tschutter/digital-dc-power-supply/doc/buttons.gif

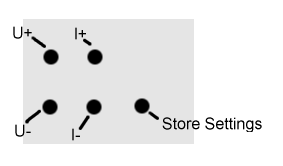
doc/buttons.gif
