tschutter/digital-dc-power-supply/software/circuit/powersupply_upd2.gif

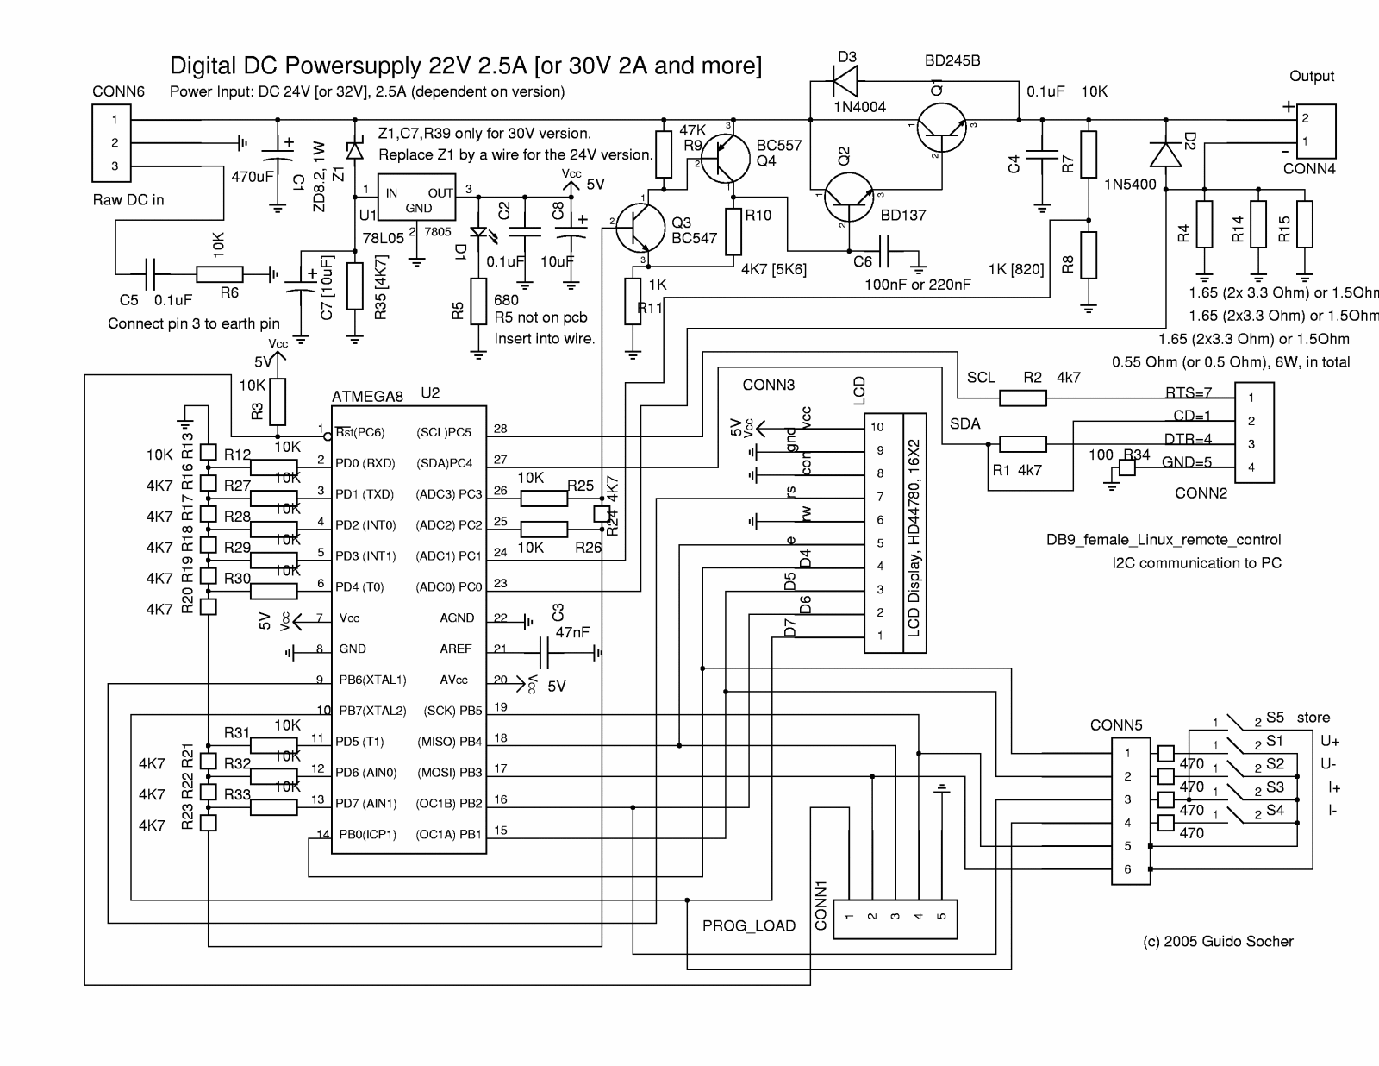
software/circuit/powersupply_upd2.gif
