tschutter/digital-dc-power-supply/software/circuit/powersupply_upd2.png

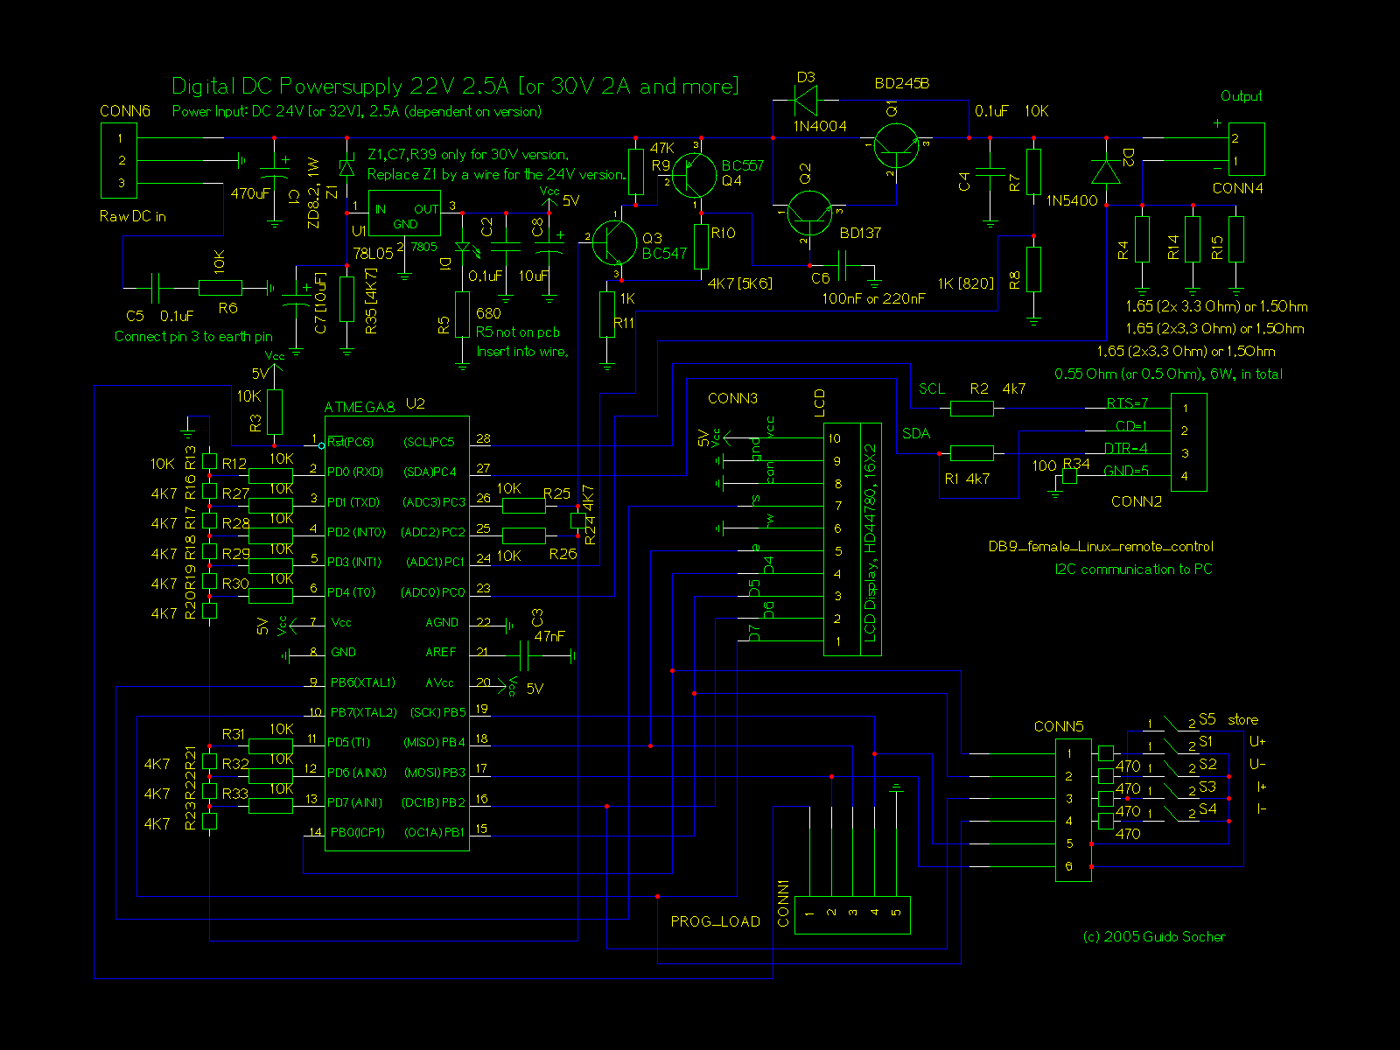
software/circuit/powersupply_upd2.png
