tschutter/digital-dc-power-supply/software/circuit/powersupply_upd3.png

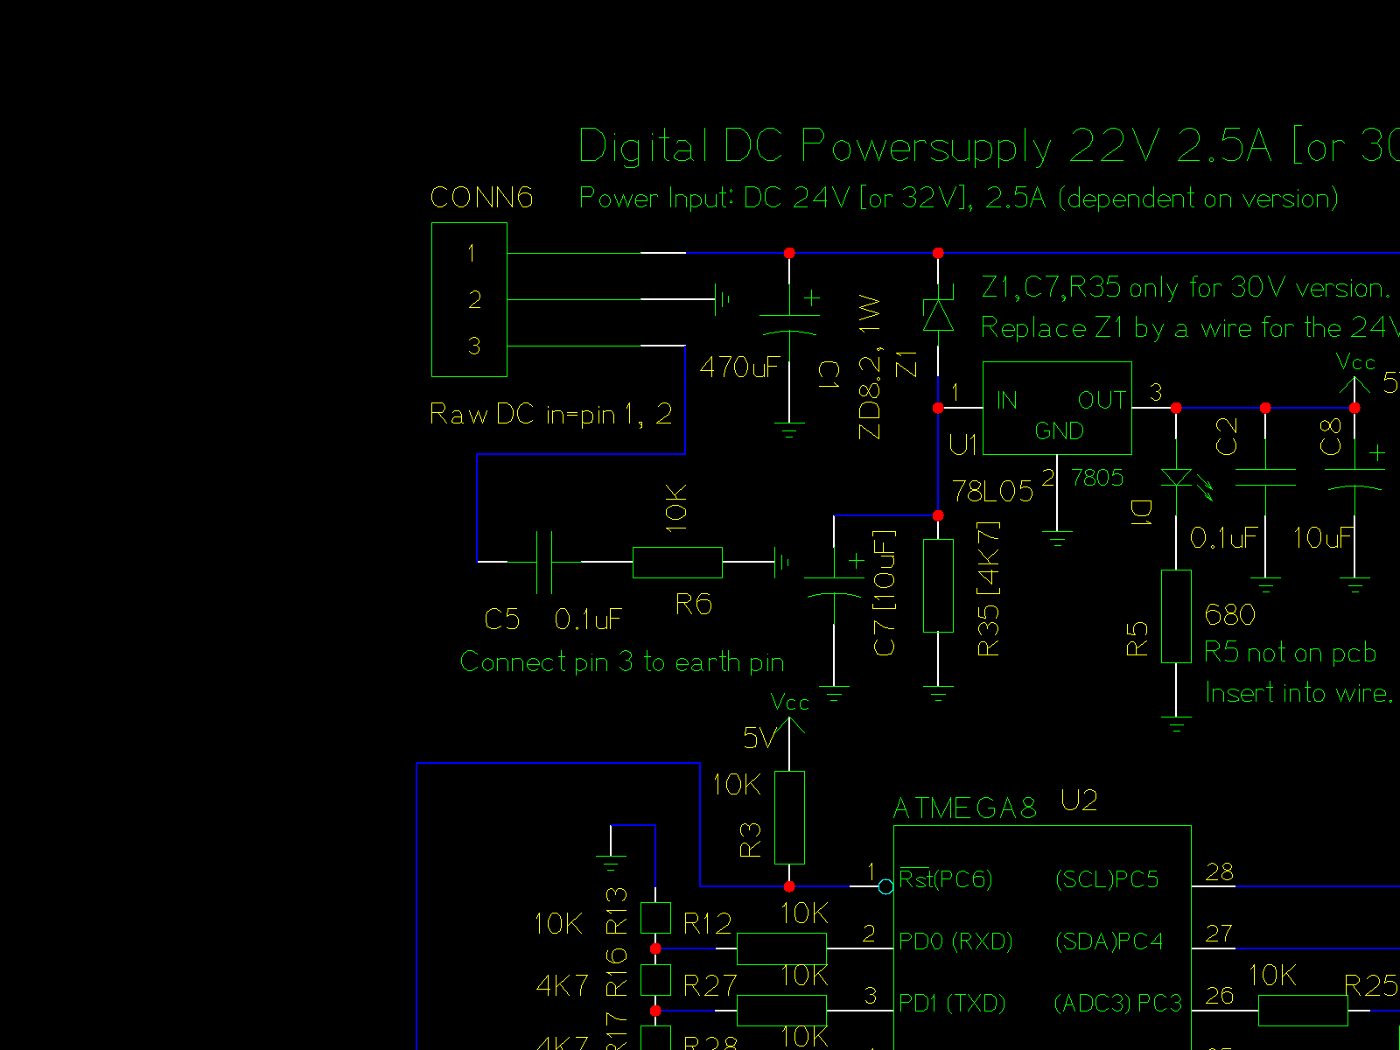
software/circuit/powersupply_upd3.png
