tschutter/digital-dc-power-supply/software/circuit/powersupply_upd4.gif

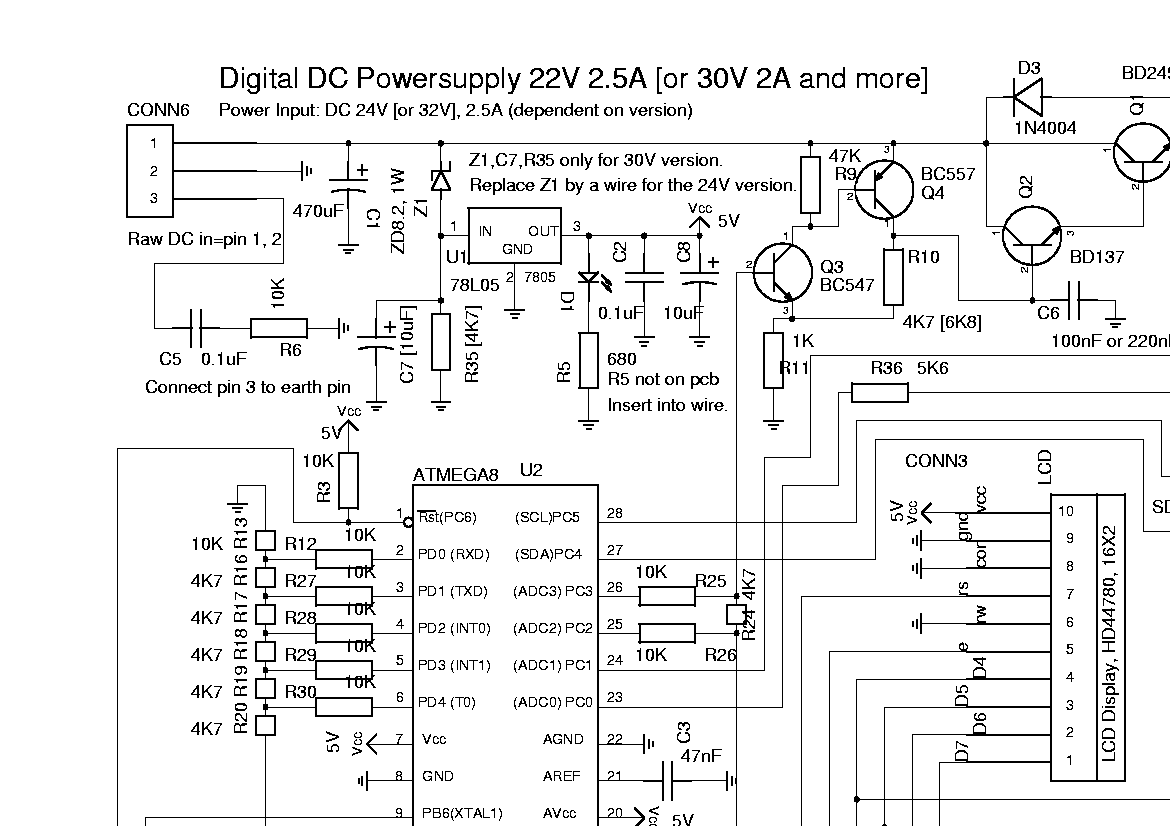
software/circuit/powersupply_upd4.gif
