tschutter/digital-dc-power-supply/software/circuit/powersupply_upd4.png

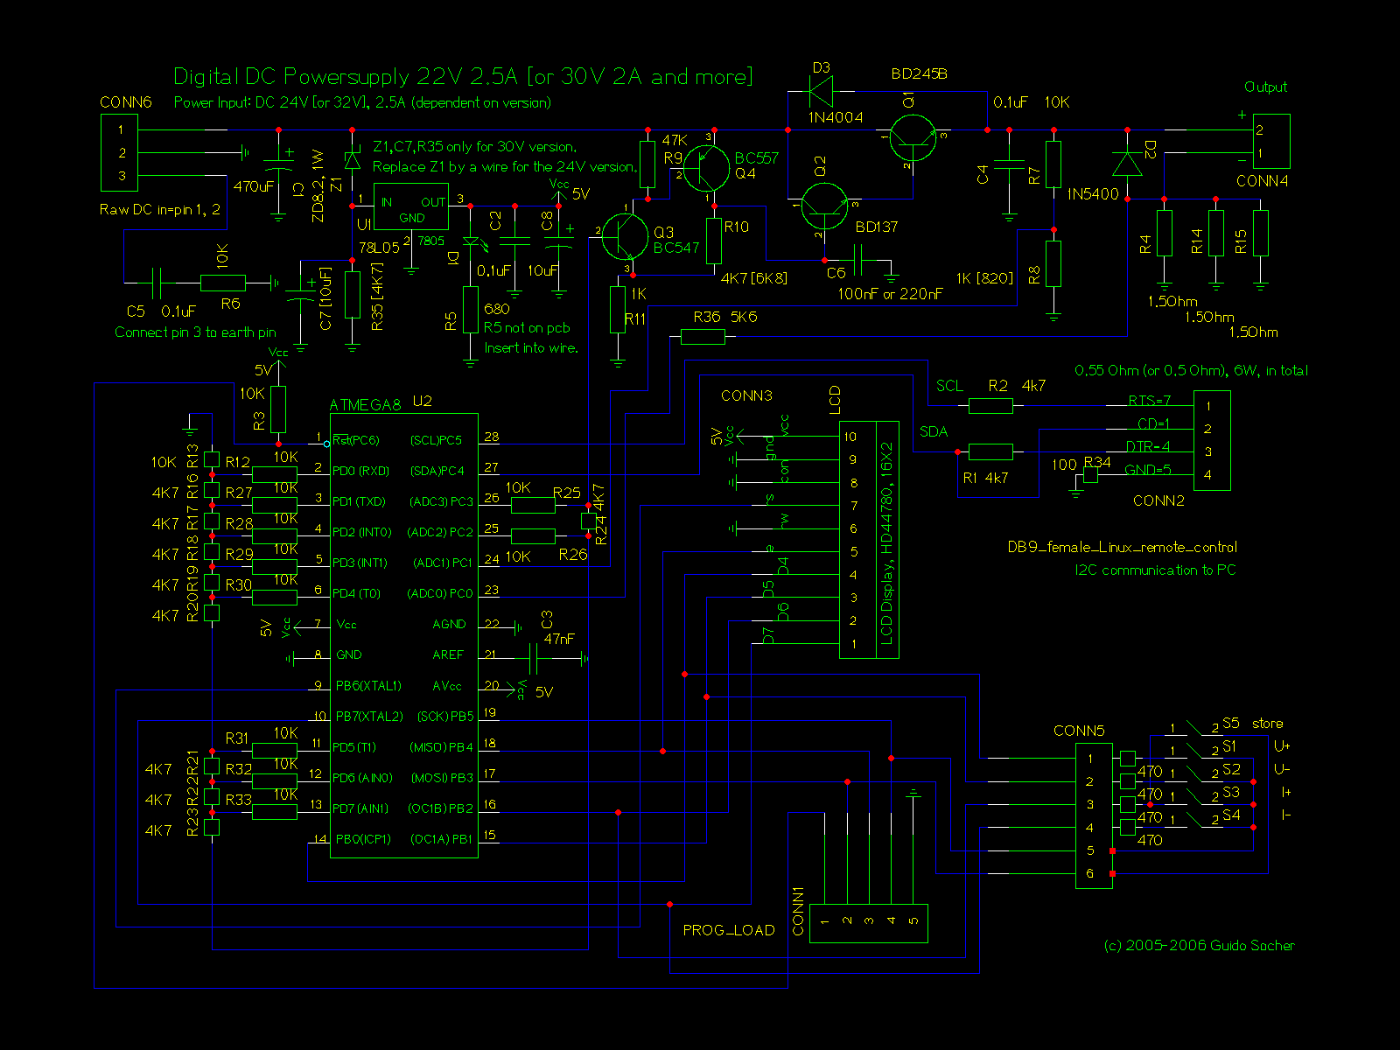
software/circuit/powersupply_upd4.png
