tschutter/digital-dc-power-supply/software/circuit/powersupply_upd.gif

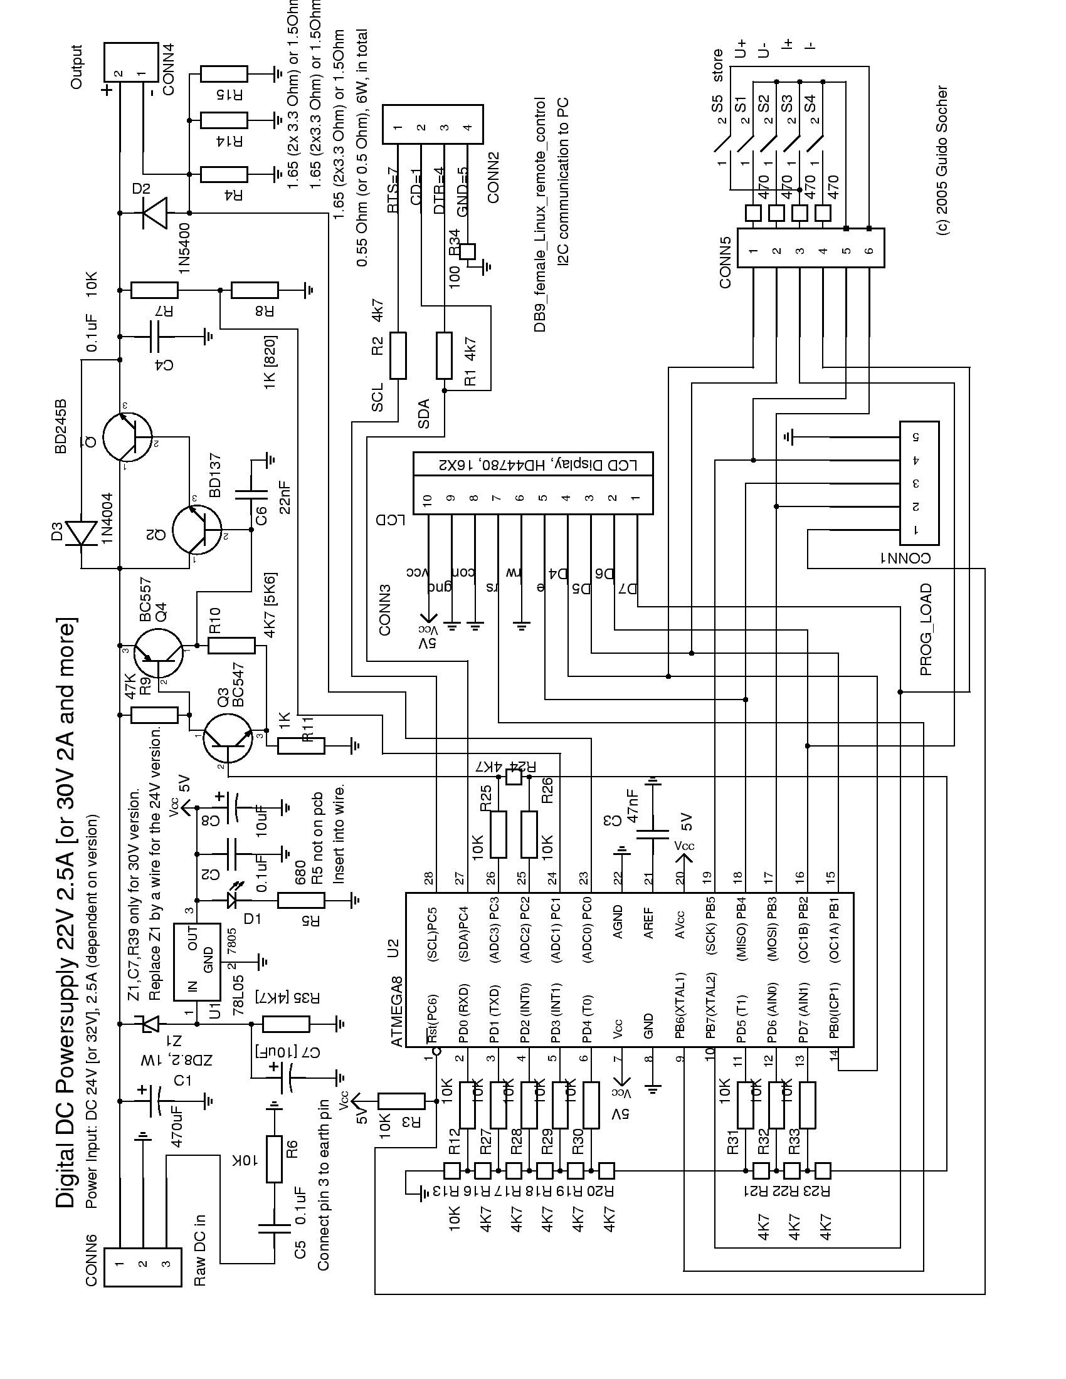
software/circuit/powersupply_upd.gif
