tschutter/digital-dc-power-supply/software/circuit/powersupply_upd.png

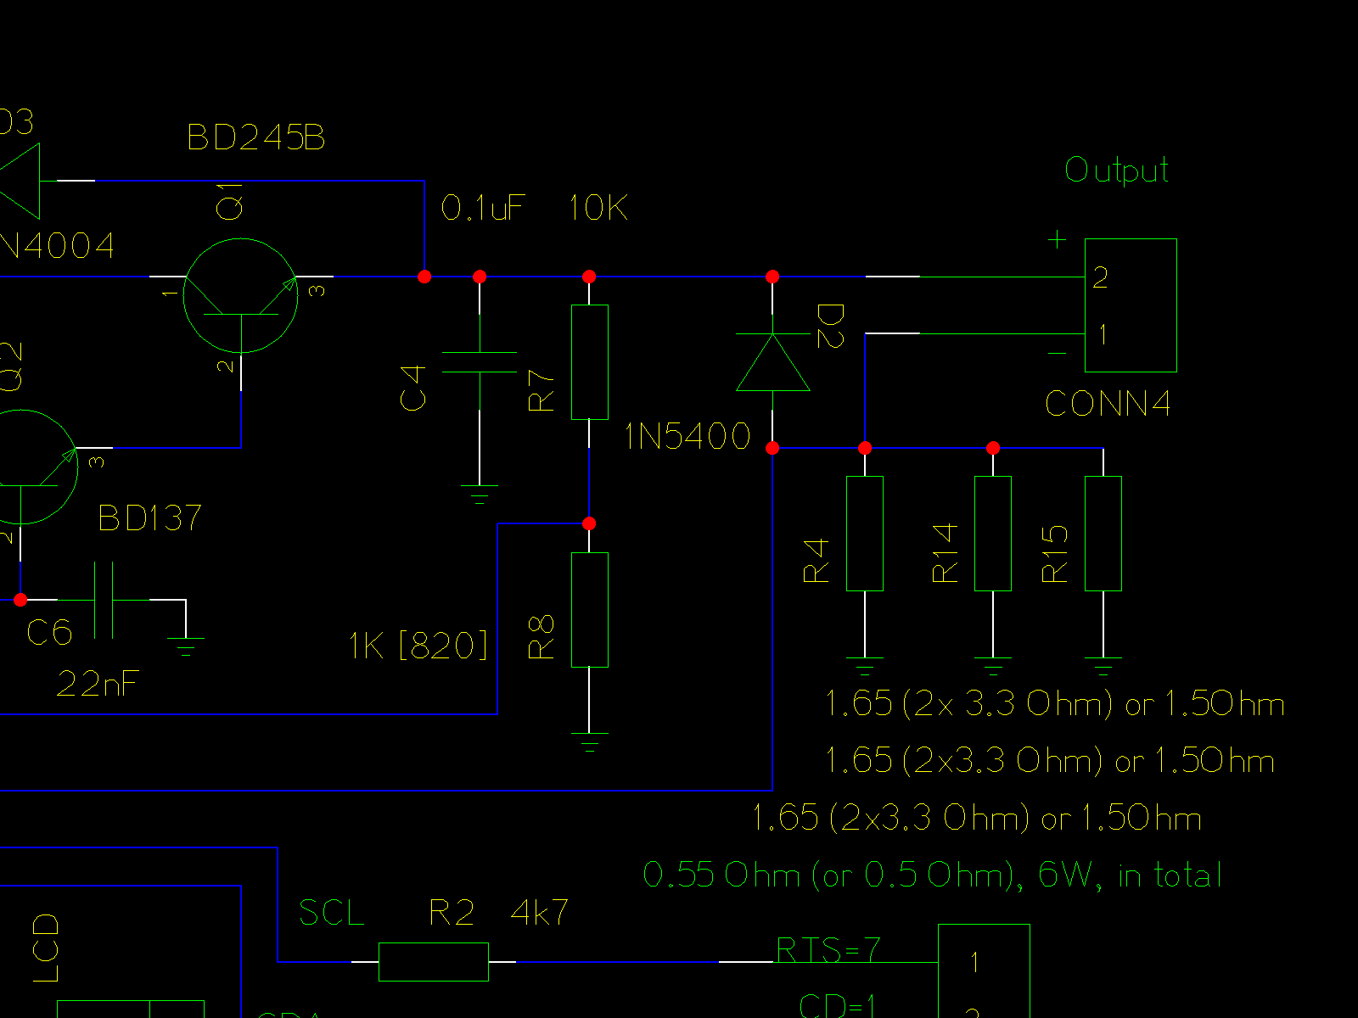
software/circuit/powersupply_upd.png
