tschutter/digital-dc-power-supply/software/circuit/powersupply_upd.pdf

## Digital DC Powersupply 22V 2.5A [or 30V 2A and more]

+

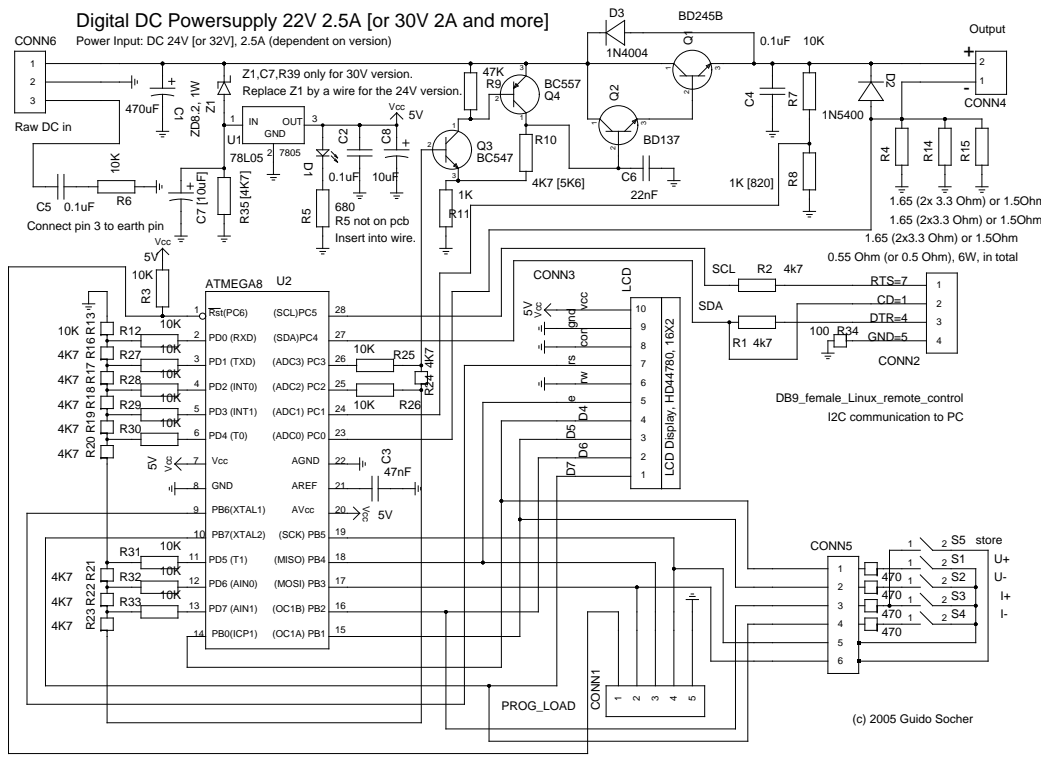
[picture p25: page 1]

Power Input: DC 24V [or 32V], 2.5A (dependent on version)

Z1,C7,R39 only for 30V version.
Replace Z1 by a wire for the 24V version.

1.65 (2x 3.3 Ohm) or 1.5Ohm
1.65 (2x3.3 Ohm) or 1.5Ohm
0.55 Ohm (or 0.5 Ohm), 6W, in total

Connect pin 3 to earth pin

17 (MOSI) PB3
