tschutter/digital-dc-power-supply/software/circuit/powersupply_upd4.pdf

## Digital DC Powersupply 22V 2.5A [or 30V 2A and more]

+

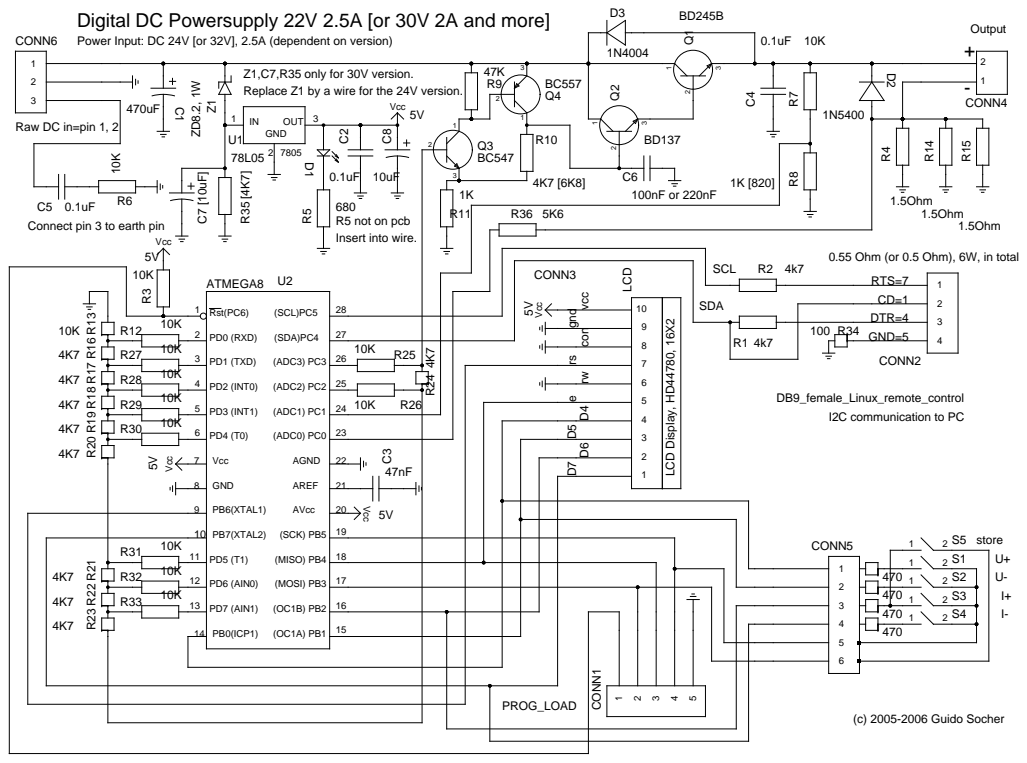
[picture p26: page 1]

Power Input: DC 24V [or 32V], 2.5A (dependent on version)

Z1,C7,R35 only for 30V version.
Replace Z1 by a wire for the 24V version.

Connect pin 3 to earth pin

0.55 Ohm (or 0.5 Ohm), 6W, in total

17 (MOSI) PB3
