tschutter/digital-dc-power-supply/(commit log)

2015-12-13 initial checkin
    [powersupply_upd.sch, powersupply_upd2.sch, powersupply_upd3.sch]
2015-12-13 added circuit diagram
2015-12-13 README.rst: fixed circuit diagram link syntax
2015-12-13 added doc/lf-2005_06-0379-assembly.pdf
2015-12-14 README.rst: changed voltage option to 22V
2015-12-14 README.rst: identified source of transformer spec voltage error
2015-12-14 README.rst: added fuse section
2015-12-14 README.rst: fixed link to The Valve Wizard
2015-12-14 README.rst: a fuse is a good idea
2015-12-14 README.rst: added stuff about multiple input voltages
2015-12-15 README.rst: added ripple voltage calculation
2015-12-15 digitaldcpower-0.4.9 -> software prior to making changes
    [powersupply_upd.sch, powersupply_upd2.sch, powersupply_upd3.sch]
2015-12-17 README.rst: added Enclosure section
2015-12-19 README.rst: added "Anatomy of Switching Power Supplies" link
2015-12-20 README.rst: added comment about R10 being wrong in circuit diagram
2015-12-20 README.rst: added screw terminals to additional part list
2015-12-22 README.rst: updated enclosure
2016-01-10 README.rst: removed noise about building for 22V initially
2016-01-10 README.rst: updated enclosure section
2016-01-10 README.rst: added current rating to 2 pin screw terminal block
2016-01-11 README.rst: removed unused screw terminal blocks
2016-01-12 README.rst: changed programming cable from adapter to cable
2016-01-12 README.rst: adjusted GND pin on Pocket AVR Programmer cable for lower stress
2016-01-12 README.rst: added text about protection resistors in programming cable
2016-01-13 README.rst: added button layout diagram
2016-01-13 buttons.gif: initial checkin
2016-01-13 README.rst: fixed link to local buttons.gif
2016-01-18 README.rst: added "Power Indicator LED" and "Cutting the Enclosure" sections
2016-01-18 README.rst: added LCD display cable pins, ribbon cable notes
2016-01-24 README.rst: fixed DC out pinout, added more text about Power Indicator LED
